FraEgg/commodore-1541-switchless-floppydrive-8x-multi-floppy-speeder/images/v2.1_pcb_1541_render_JP-SW.jpg

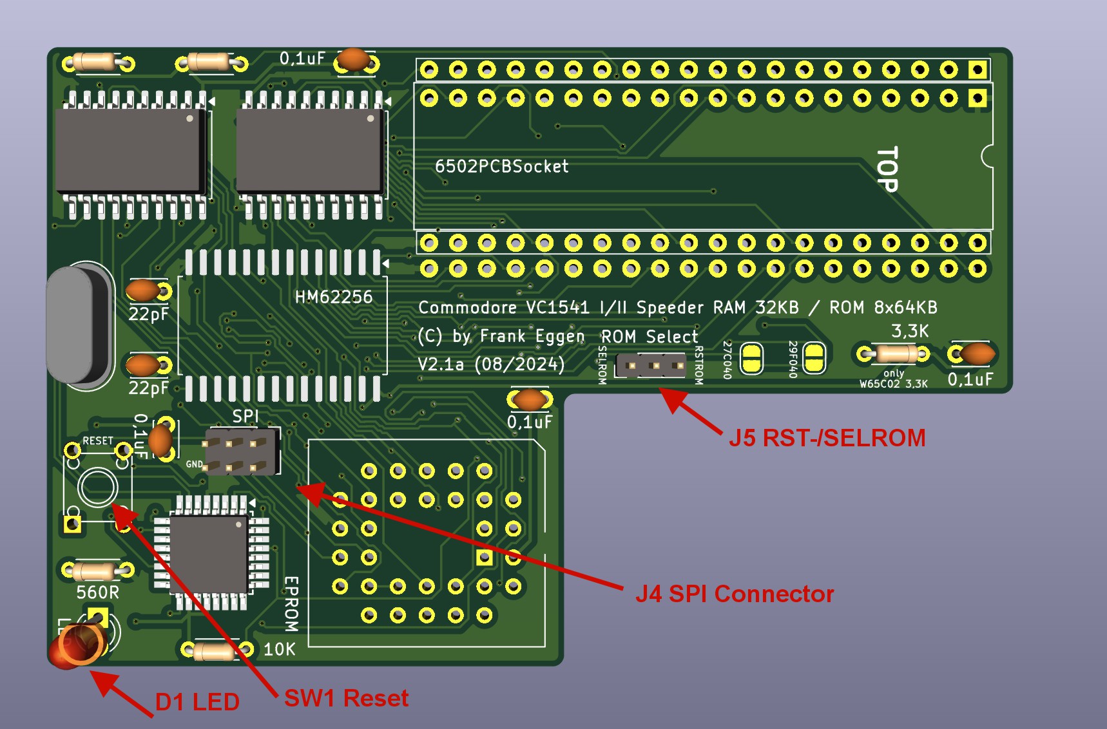
images/v2.1_pcb_1541_render_JP-SW.jpg
