FraEgg/commodore-1541-switchless-floppydrive-8x-multi-floppy-speeder/images/v2.1_pcb_proto.jpg

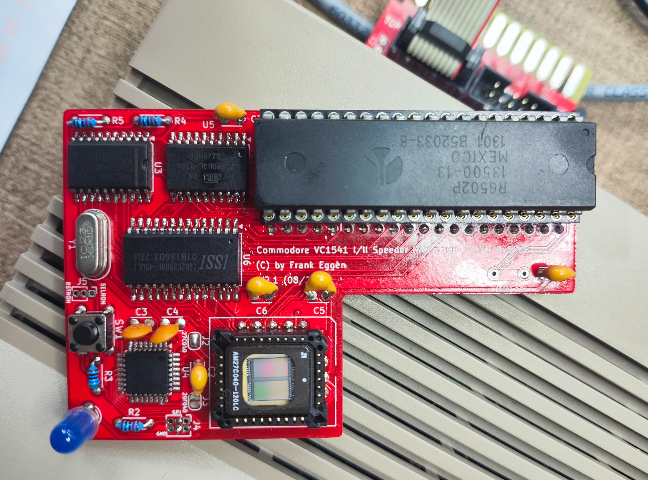
images/v2.1_pcb_proto.jpg
