FraEgg/commodore-1541-switchless-floppydrive-8x-multi-floppy-speeder/images/V2.1a_8xMulti-Floppy-Speeder_PCB_DIP.png

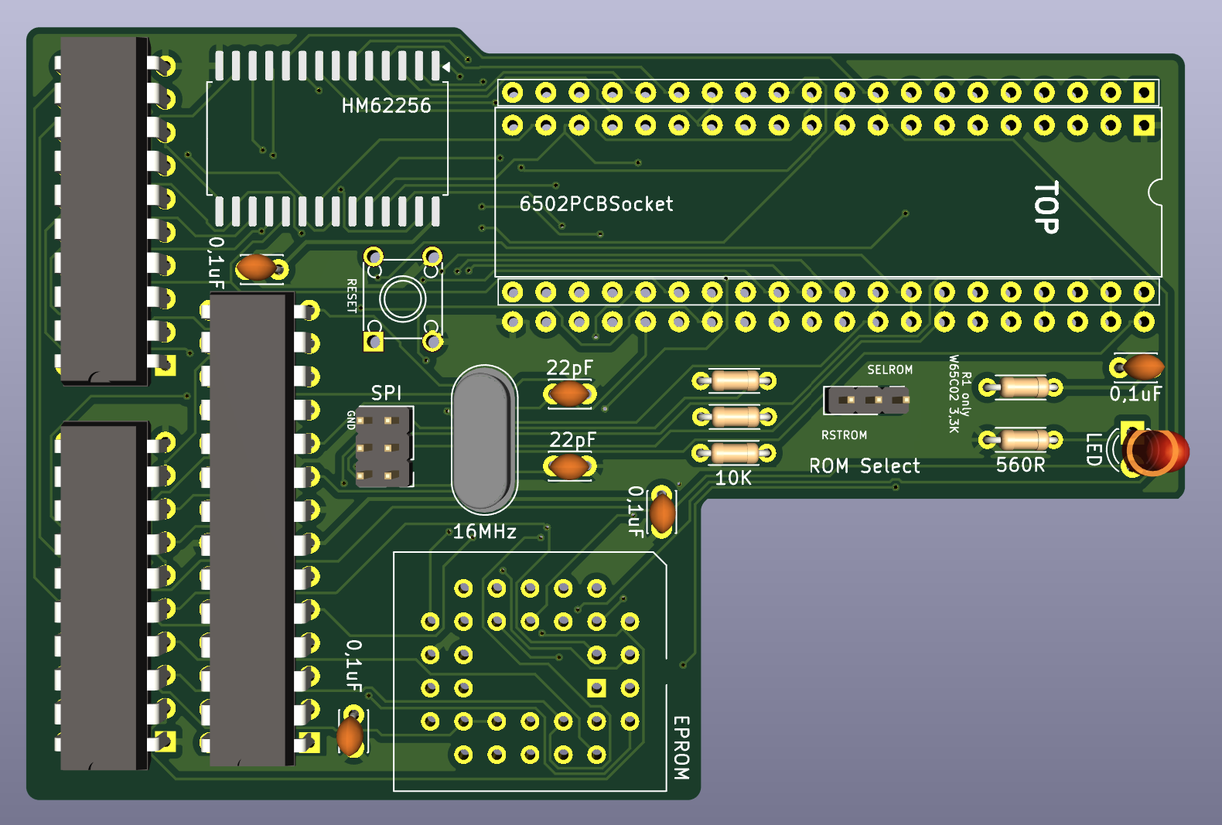
images/V2.1a_8xMulti-Floppy-Speeder_PCB_DIP.png
