FraEgg/commodore-1541-switchless-floppydrive-8x-multi-floppy-speeder/images/v2.1b_Multi-Speeder RAM 32KB_ROM 8x64KB.F.png

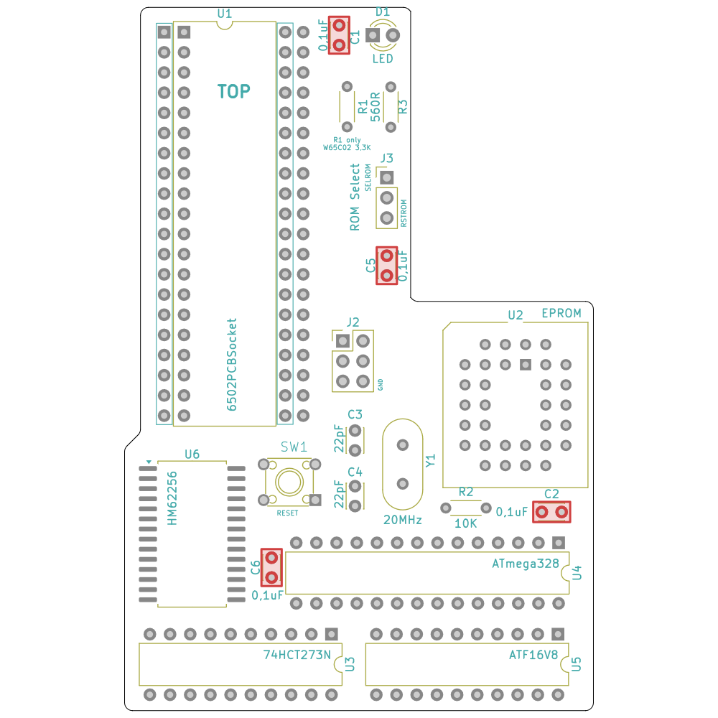
images/v2.1b_Multi-Speeder RAM 32KB_ROM 8x64KB.F.png
