FraEgg/commodore-1541-switchless-floppydrive-8x-multi-floppy-speeder/images/v2.1b_pcb_smd.jpg

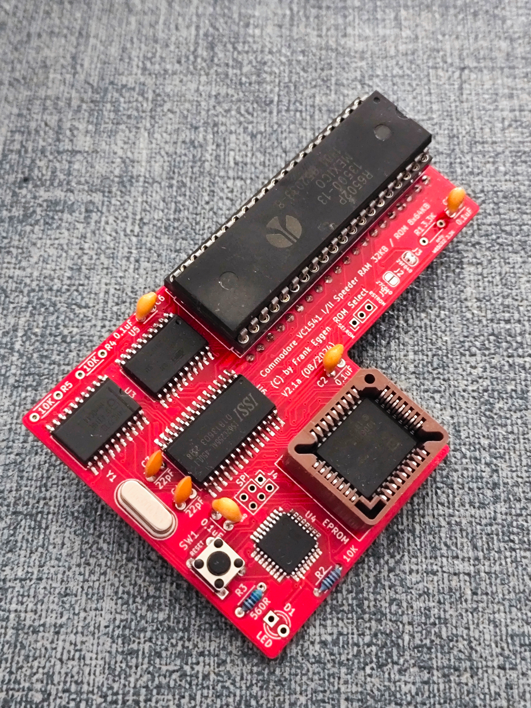
images/v2.1b_pcb_smd.jpg
