FraEgg/commodore-1541-switchless-floppydrive-8x-multi-floppy-speeder/images/v2.2b_logic.png

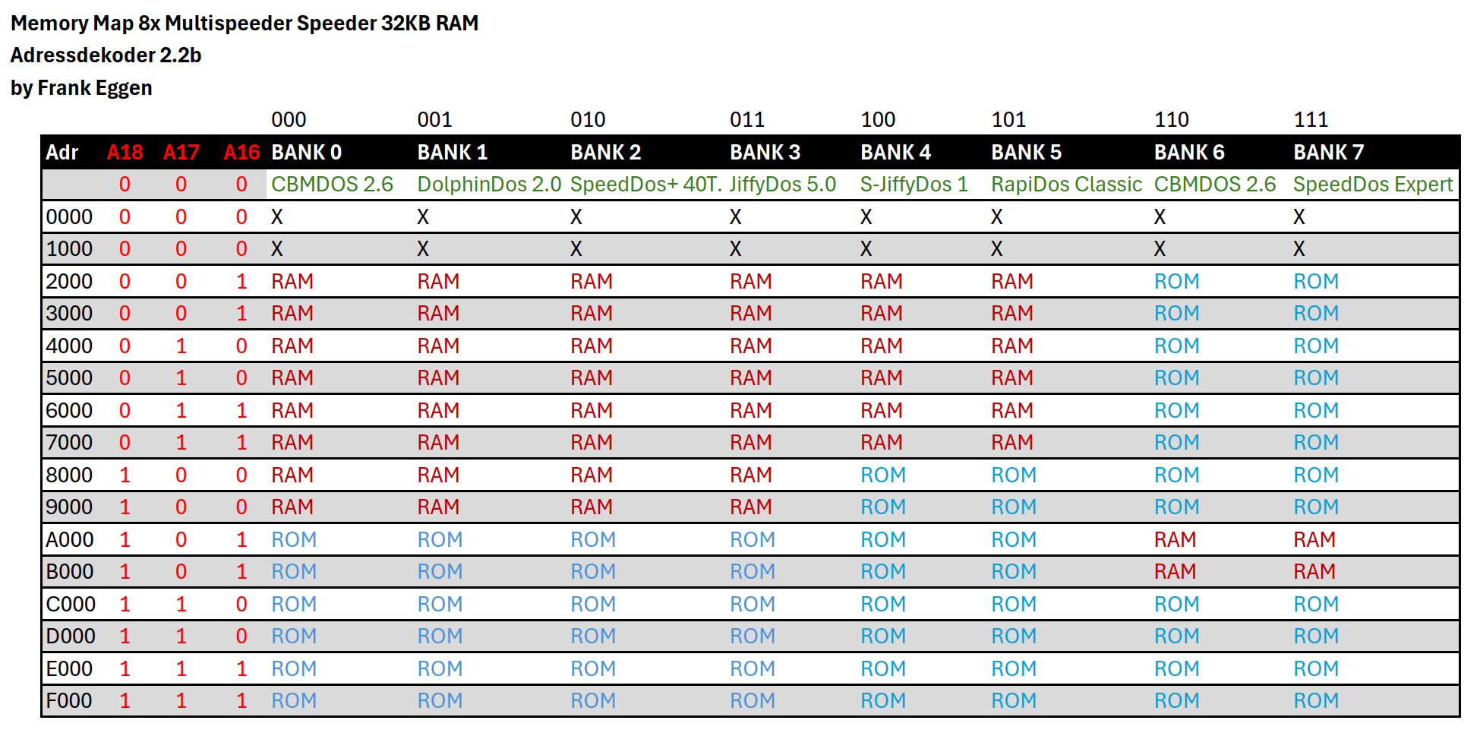
images/v2.2b_logic.png
