FraEgg/commodore-1541-switchless-floppydrive-8x-multi-floppy-speeder/images/v2.2b_pcb_1541_PCB_DIP.jpg

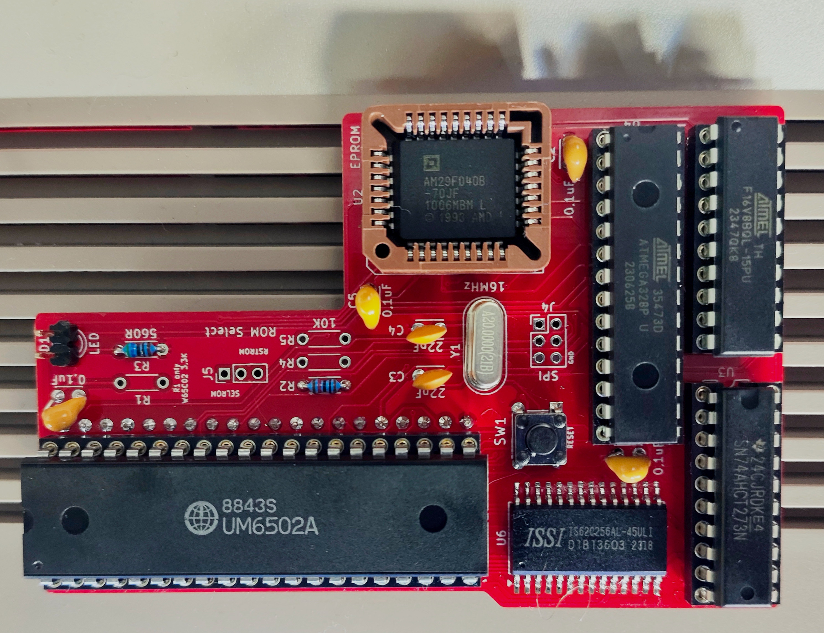
images/v2.2b_pcb_1541_PCB_DIP.jpg
