FraEgg/commodore-1541-switchless-floppydrive-8x-multi-floppy-speeder/schematic/v2.1b_1541-switchless-floppy-8x-multi-speeder.pdf

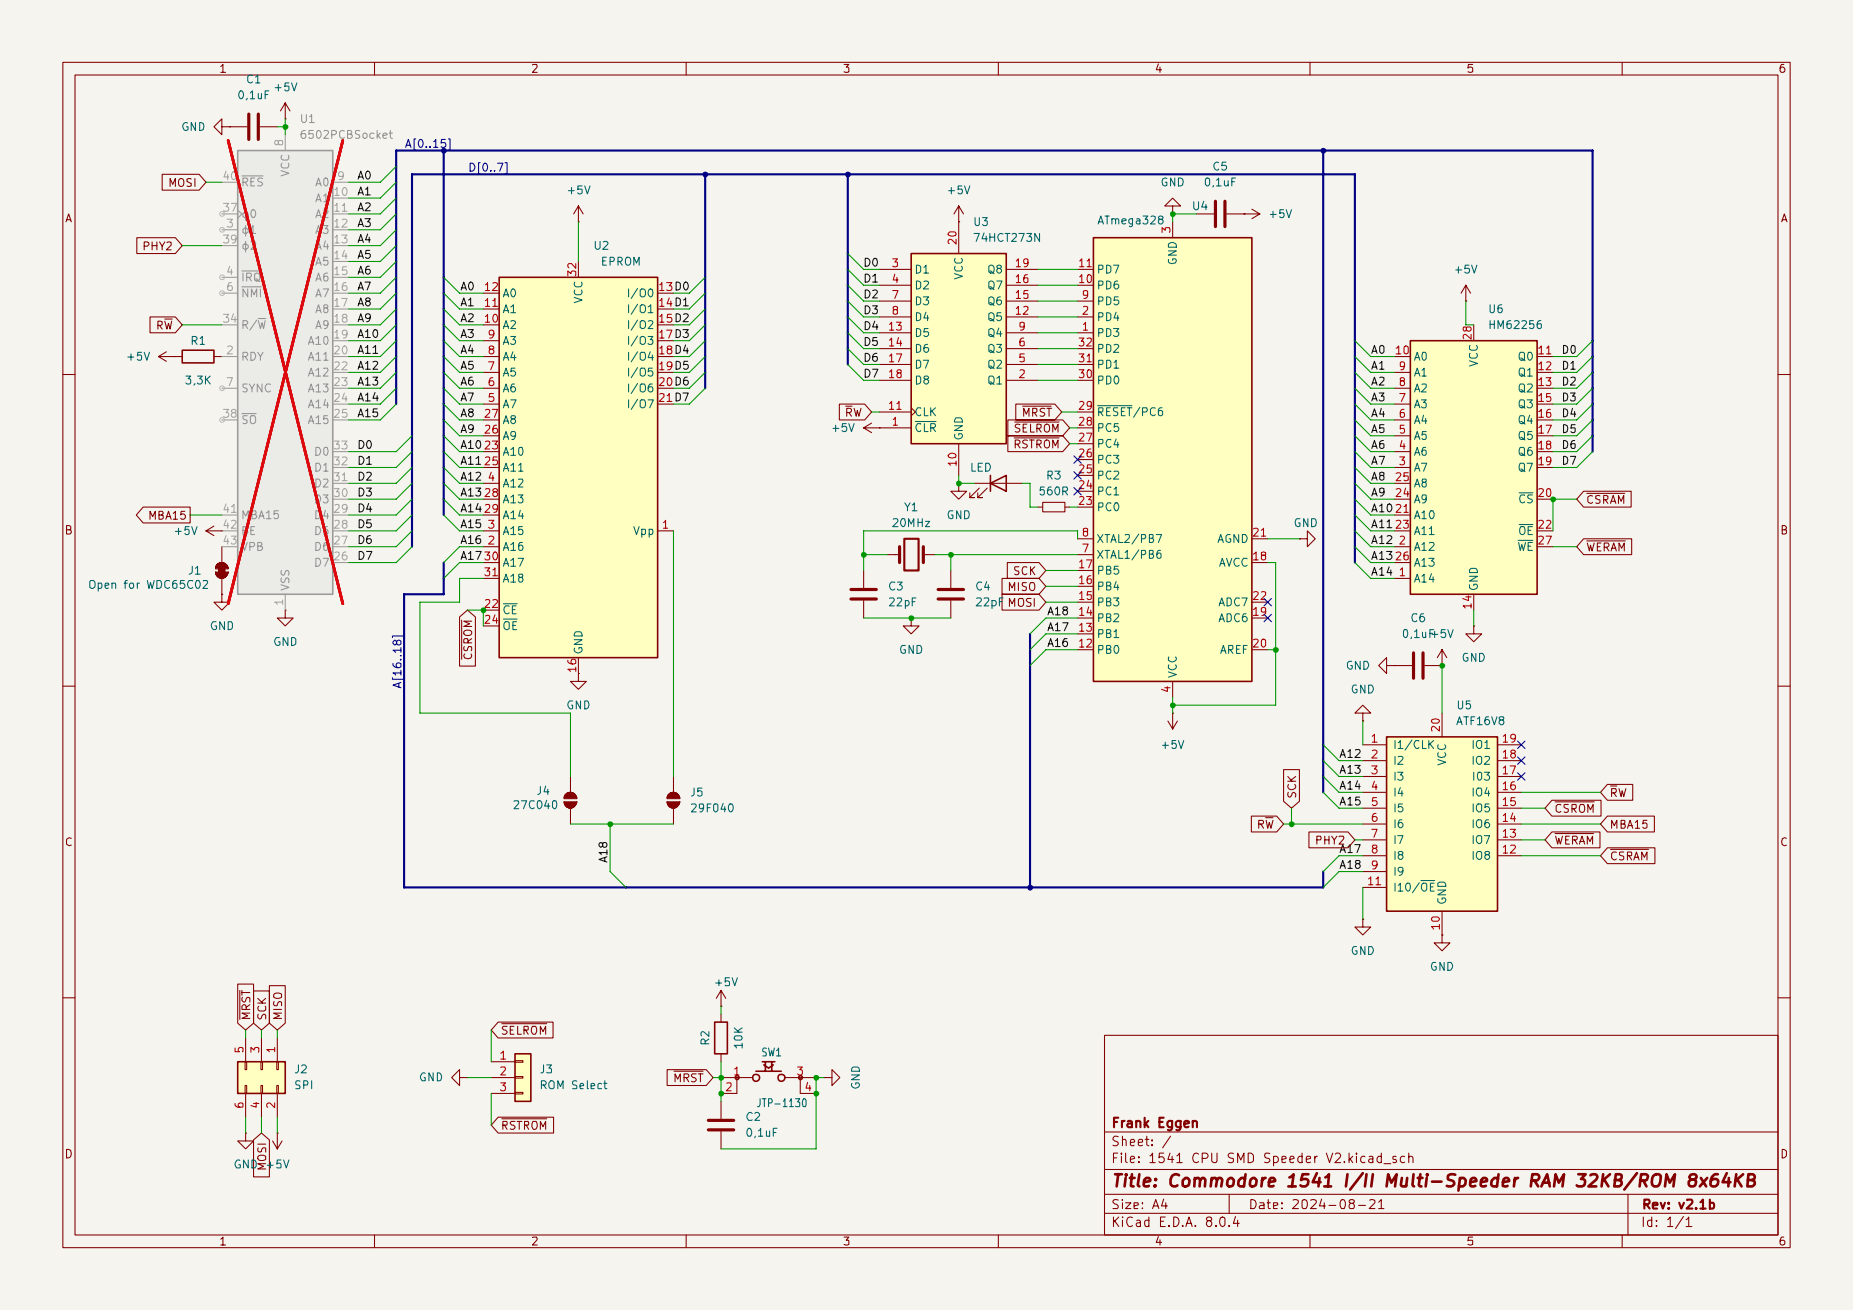
[picture p21: page 1]
