FraEgg/commodore-1541-switchless-floppydrive-8x-multi-floppy-speeder/logic/Adressdecoding_v2.2b-ROM-RAM-Banking.pdf

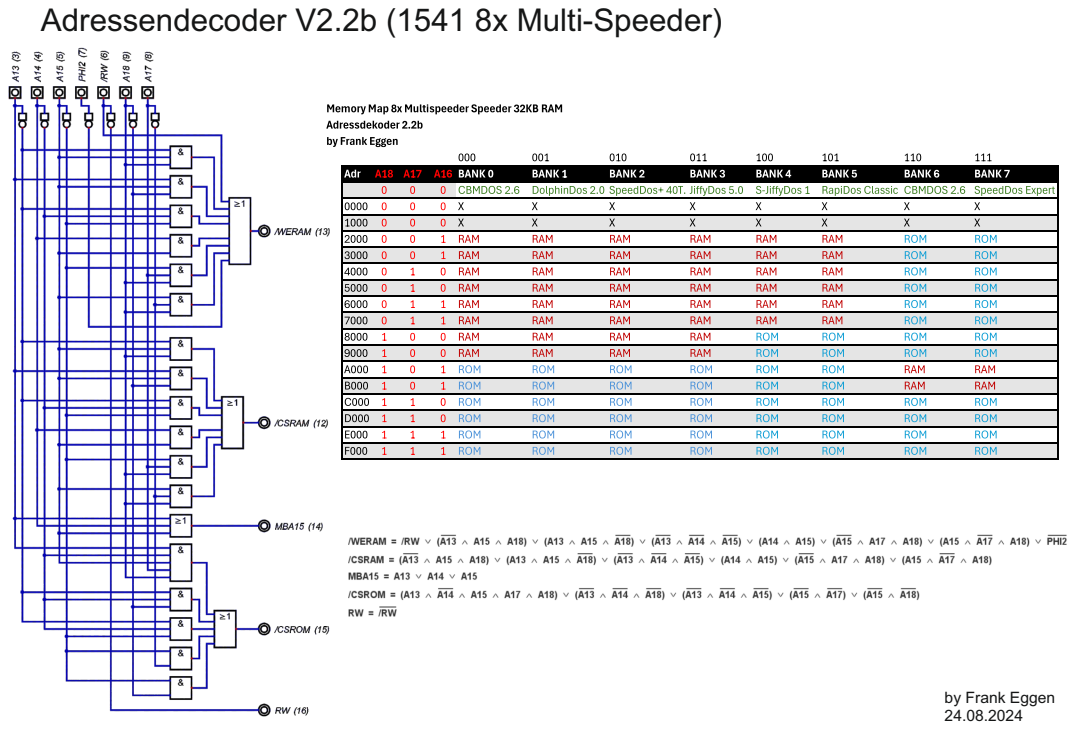
[picture p22: page 1]

Adressendecoder V2.2b (1541 8x Multi-Speeder)

by Frank Eggen
