FraEgg/commodore-1541-switchless-floppydrive-8x-multi-floppy-speeder/(commit log)

2024-08-11 Upload PCB Setup
2024-08-11 PCB Render Versions
2024-08-11 Add Logic and Schematic
2024-08-18 Add 8x multi-speeder-diagnostic tool and pcb pictures
2024-08-25 Add PCB Photos
2024-08-30 Update BOM and SpeedDos40T with GCR patch
2024-09-02 Remove Gerberfiles (Issue with 1541 Mechanical problem with the cooling fins of the voltage regulators)
